Leoneq/iNapGPU/images/bok.jpg

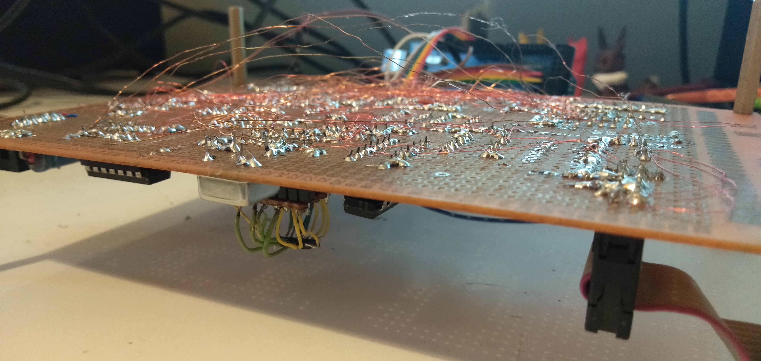
images/bok.jpg
