Leoneq/iNapGPU/images/info obraz.jpg

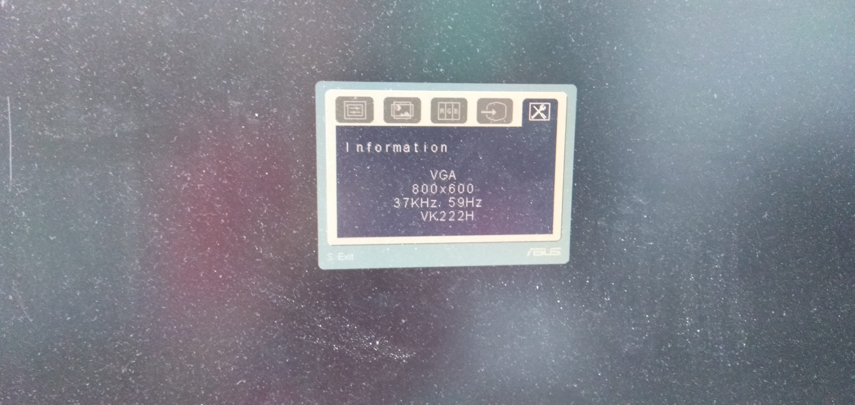
images/info obraz.jpg
