Leoneq/iNapGPU/images/inv.jpg

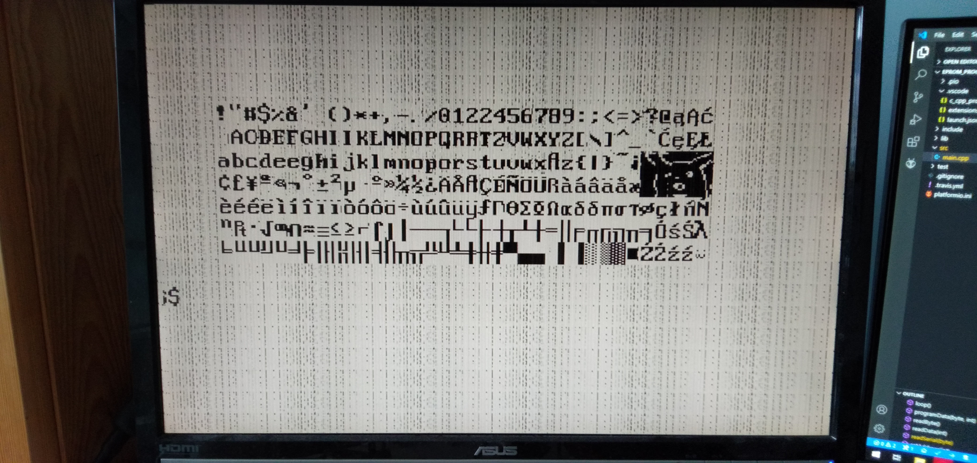
images/inv.jpg
