Leoneq/iNapGPU/images/lustro.jpg

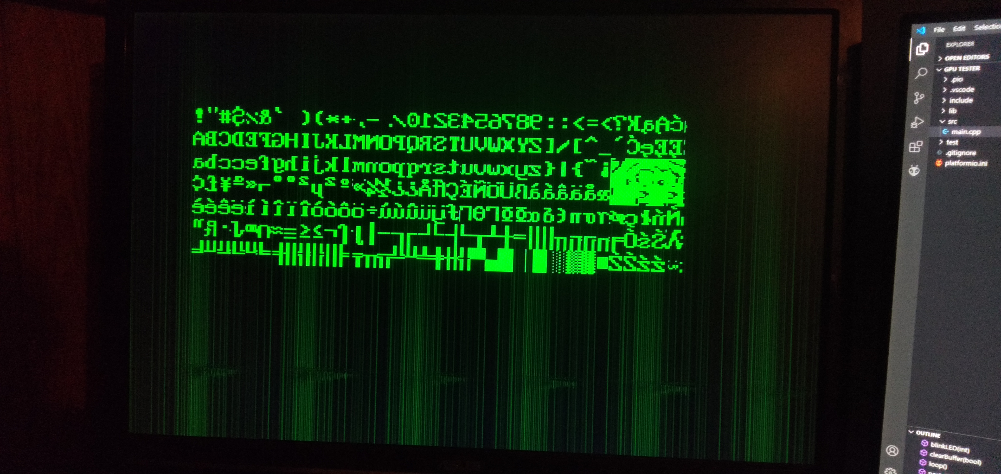
images/lustro.jpg
