Leoneq/iNapGPU/images/schematics/io.png

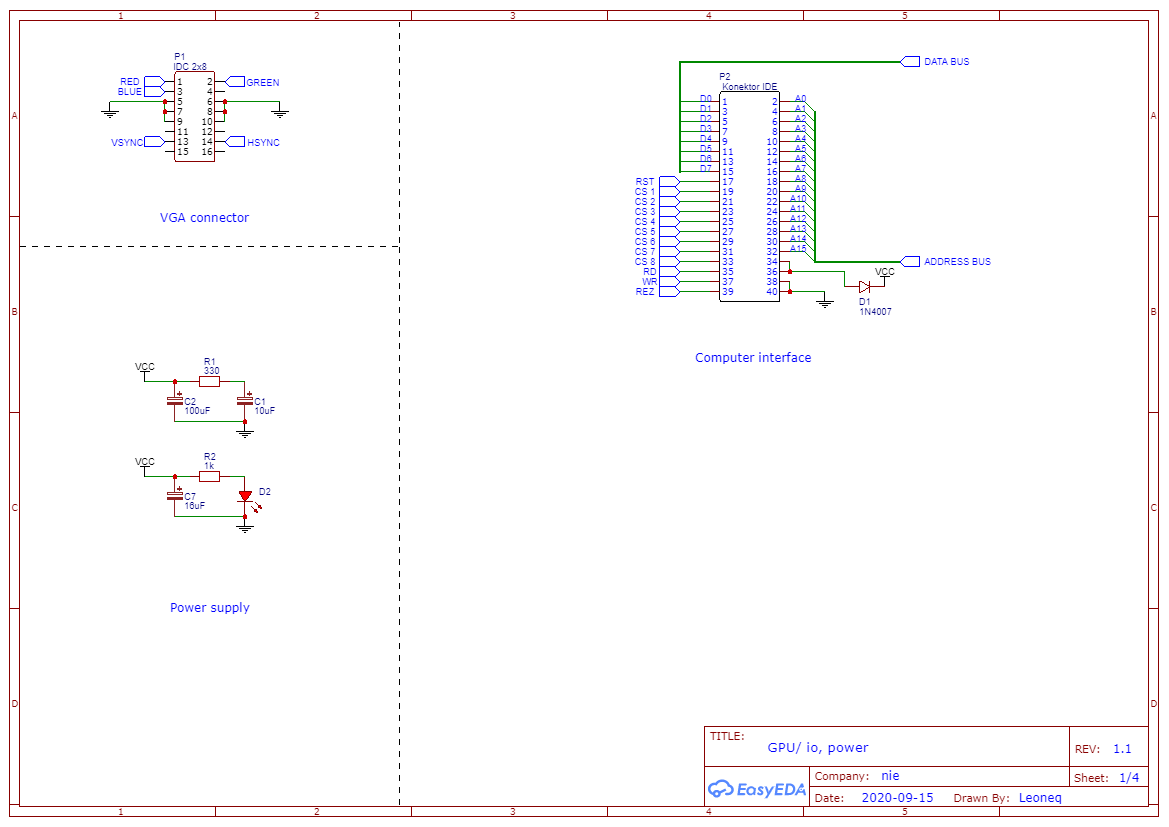
images/schematics/io.png
