Leoneq/iNapGPU/images/sga.jpg

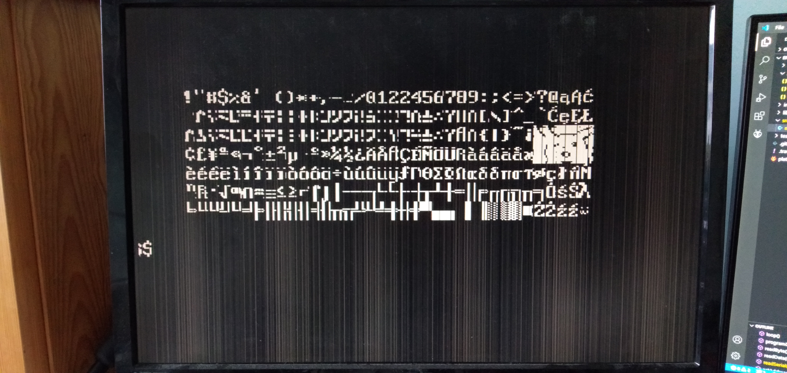
images/sga.jpg
