Leoneq/iNapGPU/images/sram.jpg

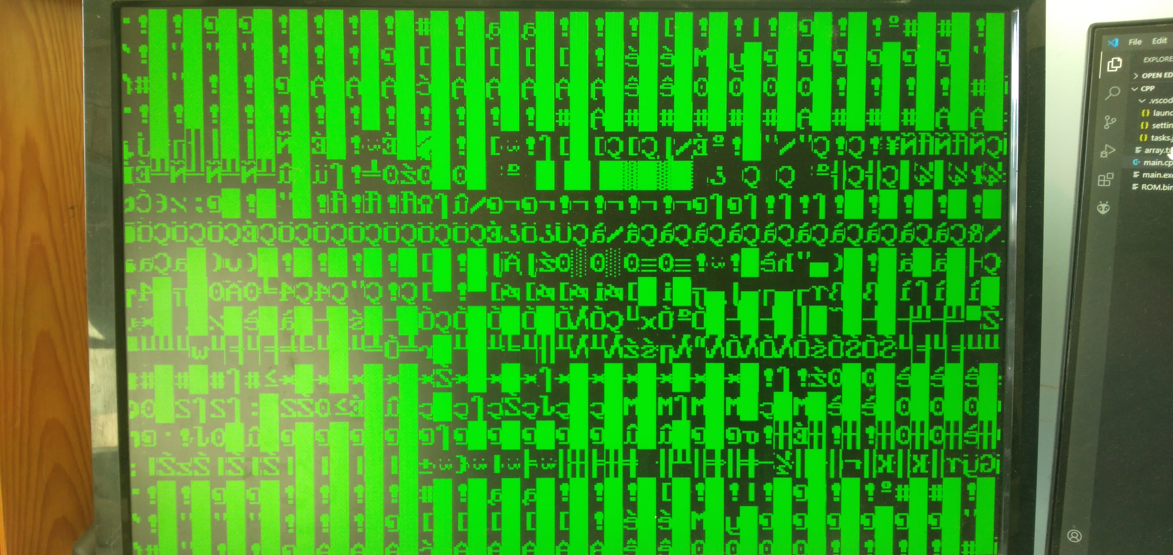
images/sram.jpg
