Leoneq/iNapGPU/images/timery.jpg

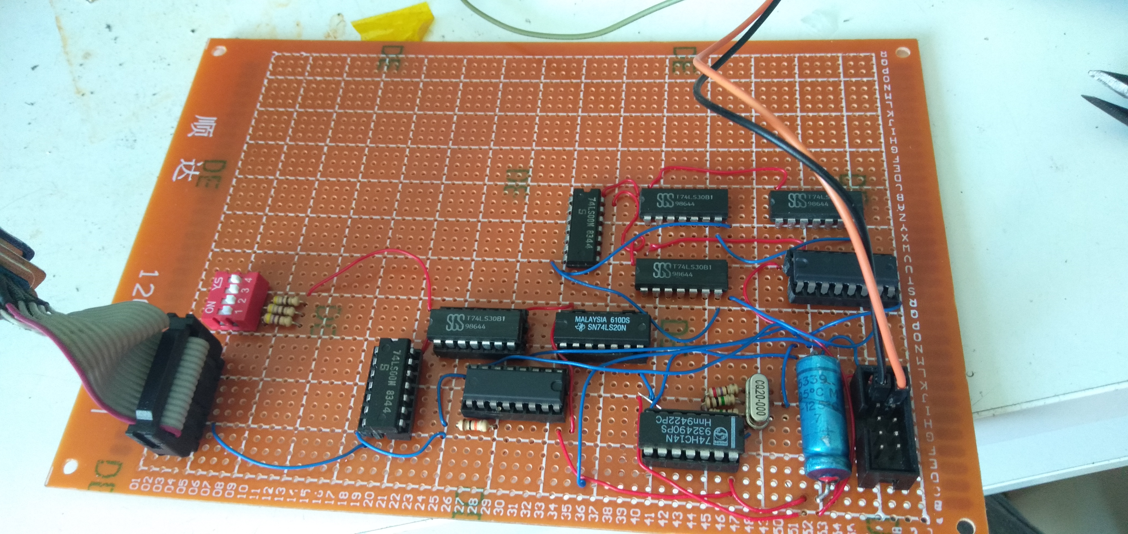
images/timery.jpg
