Leoneq/iNapGPU/images/test1.jpg

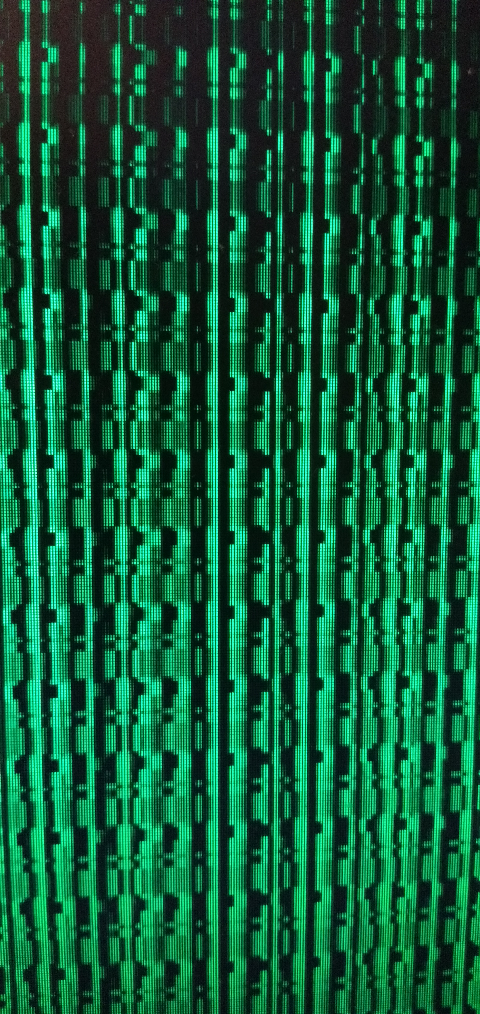
images/test1.jpg
